creatablelabs/Creatable-D3/README.md

# Creatable-D3
All drawings and sources in Creatable D3
