creatablelabs/Creatable-D3/D3 drawing files/D3 3D modeling/bottom plate assy/bed clip 5 dw 20180131.png

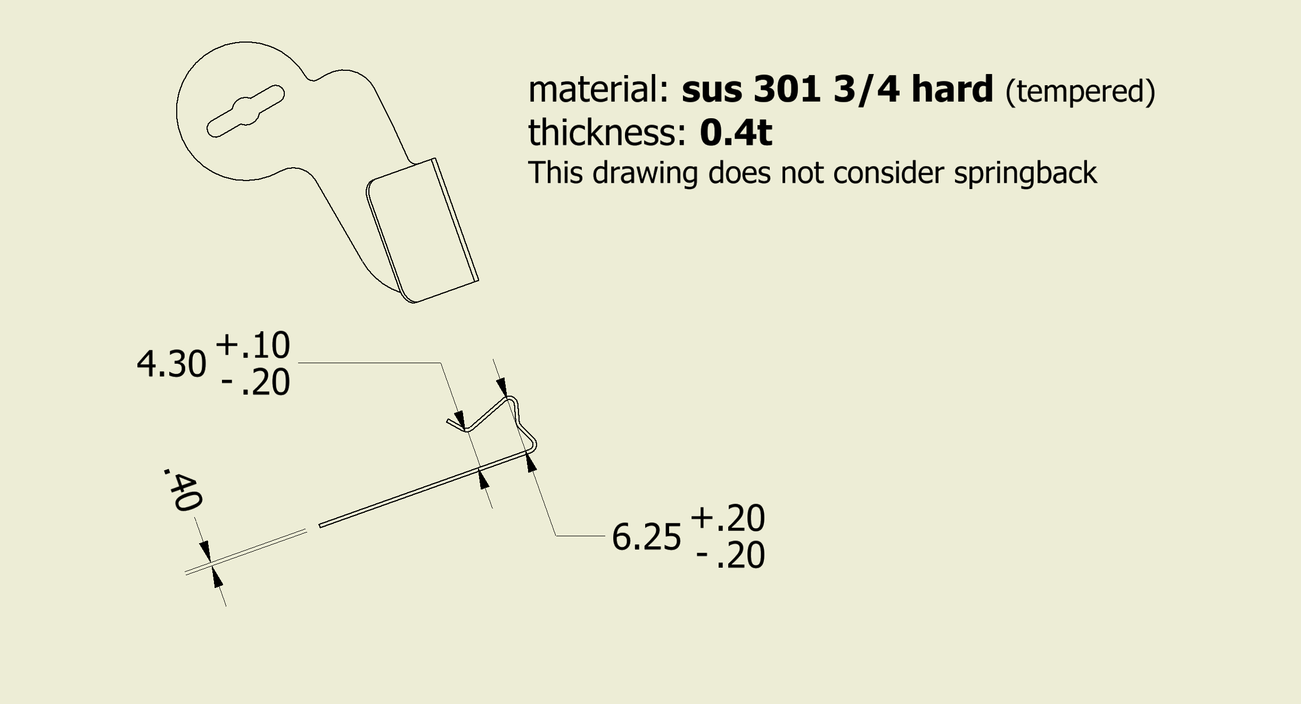
D3 drawing files/D3 3D modeling/bottom plate assy/bed clip 5 dw 20180131.png
