creatablelabs/Creatable-D3/D3 drawing files/D3 3D modeling/oled assy/이게 있어야 에러가 안뜸...png

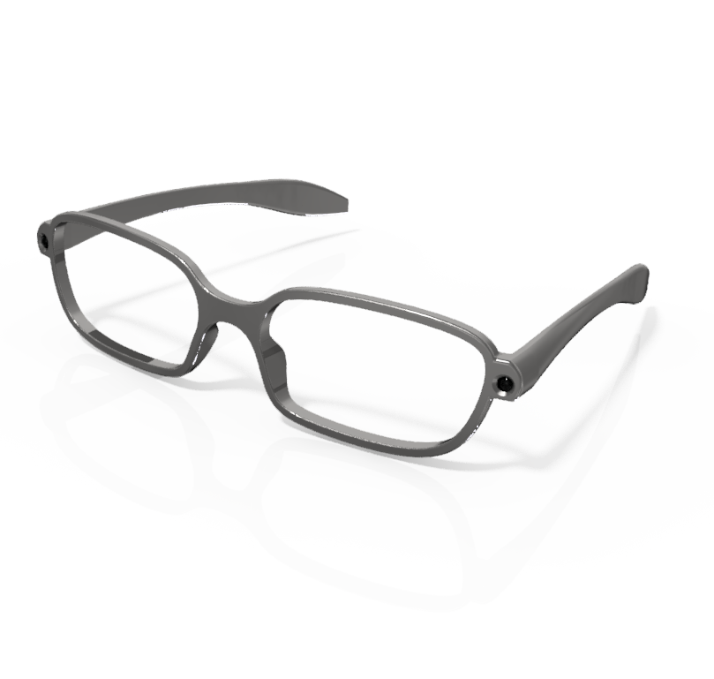
D3 drawing files/D3 3D modeling/oled assy/이게 있어야 에러가 안뜸...png
