creatablelabs/Creatable-D3/D3 drawing files/D3 3D modeling/bottom cover assy/clamp_fixer.stp

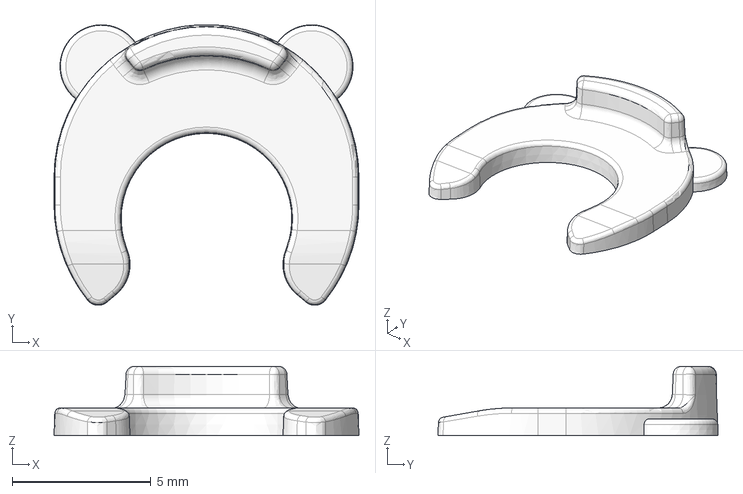
[picture p3: CAD file, 2023-02-28]
D3 drawing files/D3 3D modeling/bottom cover assy/clamp_fixer.stp
11.0 x 10.1 x 2.50 mm
