creatablelabs/Creatable-D3/D3 drawing files/D3 3D modeling/bottom plate assy/leveling_wheel.stp

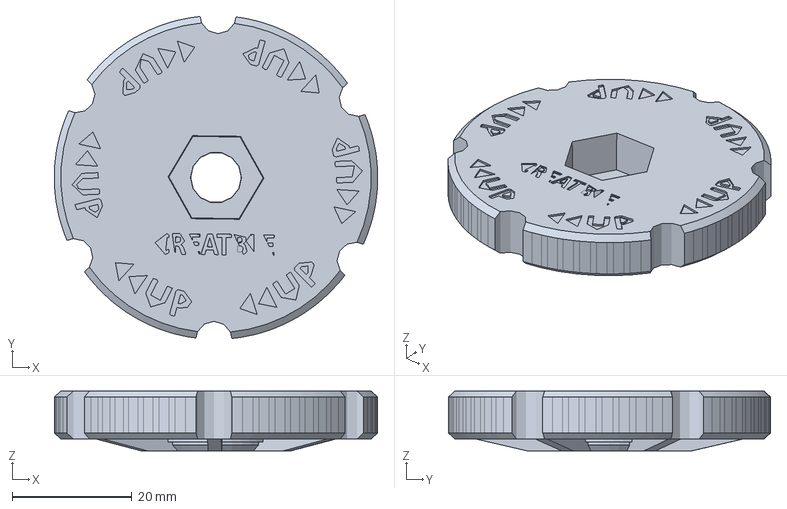
[picture p4: CAD file, 2023-02-28]
D3 drawing files/D3 3D modeling/bottom plate assy/leveling_wheel.stp
54.0 x 53.7 x 10.0 mm
