creatablelabs/Creatable-D3/D3 drawing files/D3 3D modeling/head assy/head_cover.stp

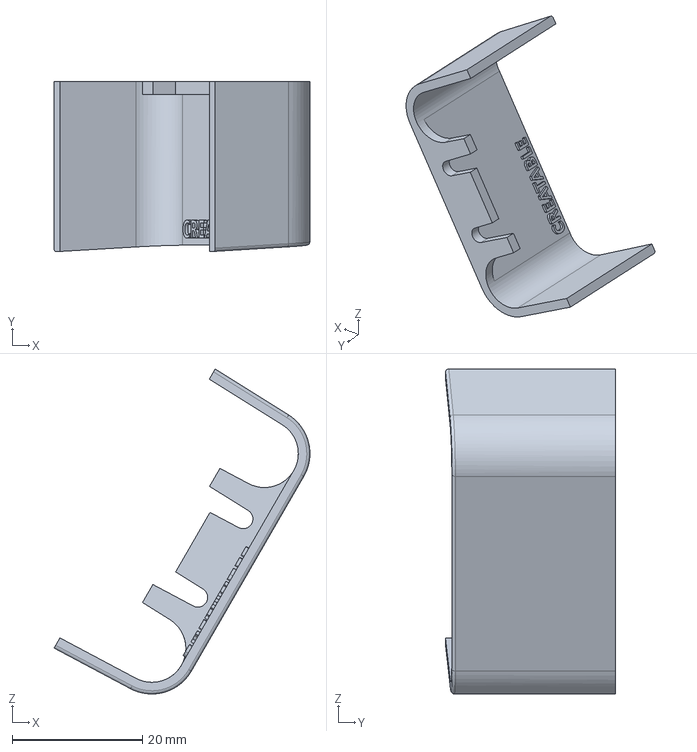
[picture p5: CAD file, 2023-02-28]
D3 drawing files/D3 3D modeling/head assy/head_cover.stp
39.2 x 26.0 x 49.8 mm
