creatablelabs/Creatable-D3/D3 drawing files/D3 3D modeling/head_cable_holder.stp

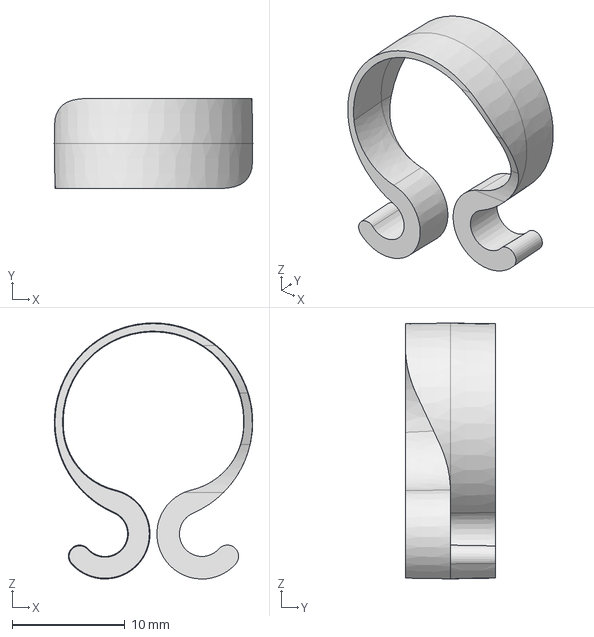
[picture p6: CAD file, 2023-02-28]
D3 drawing files/D3 3D modeling/head_cable_holder.stp
17.6 x 8.00 x 22.7 mm
