creatablelabs/Creatable-D3/D3 drawing files/D3 3D modeling/oled assy/053-Vol_Knob-0417.stp

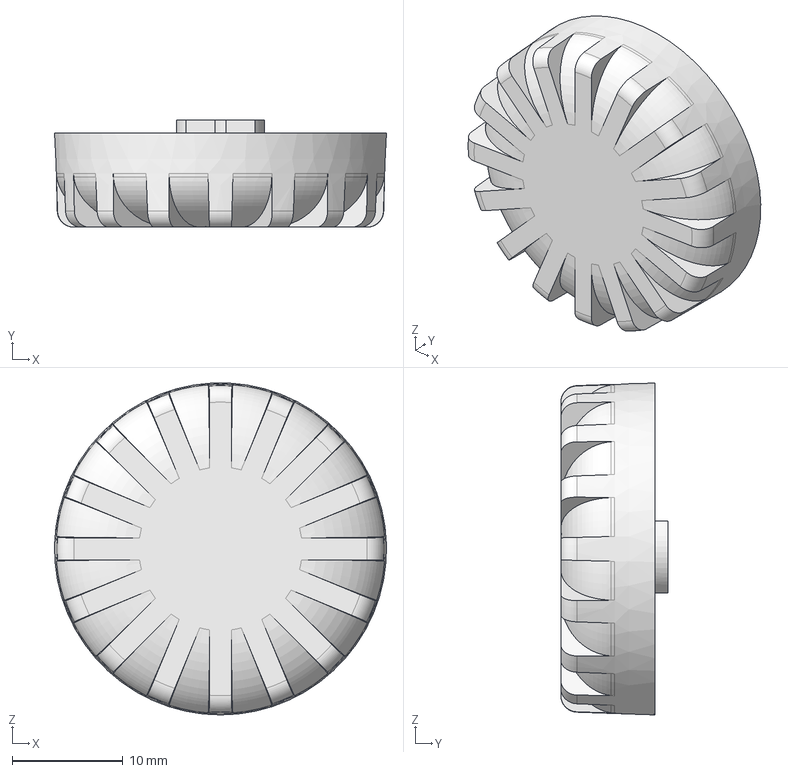
[picture p7: CAD file, 2023-02-28]
D3 drawing files/D3 3D modeling/oled assy/053-Vol_Knob-0417.stp
30.0 x 9.70 x 30.0 mm
