creatablelabs/Creatable-D3/D3 drawing files/D3 3D modeling/top plate assy/top_plate.stp

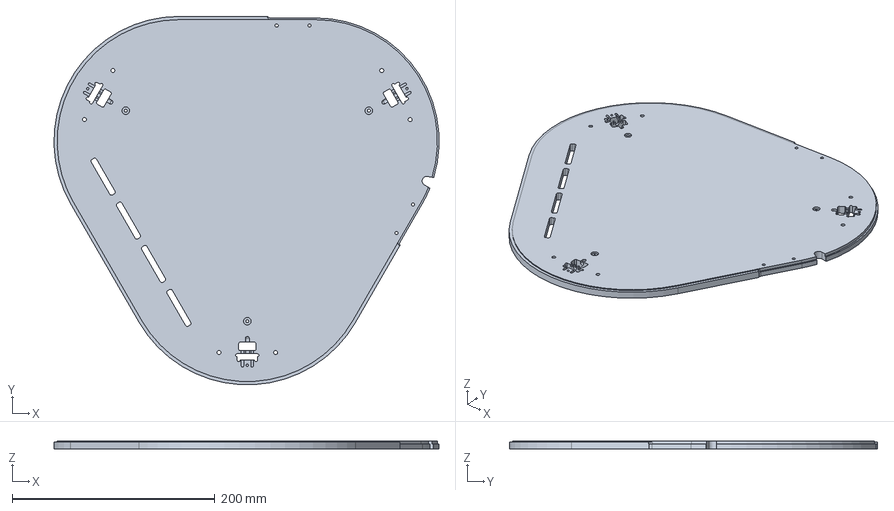
[picture p8: CAD file, 2023-02-28]
D3 drawing files/D3 3D modeling/top plate assy/top_plate.stp
380.1 x 363.5 x 8.00 mm
