creatablelabs/Creatable-D3/D3 drawing files/D3 DWG drawing/사출물/bed clip 5 20180131(new).stp

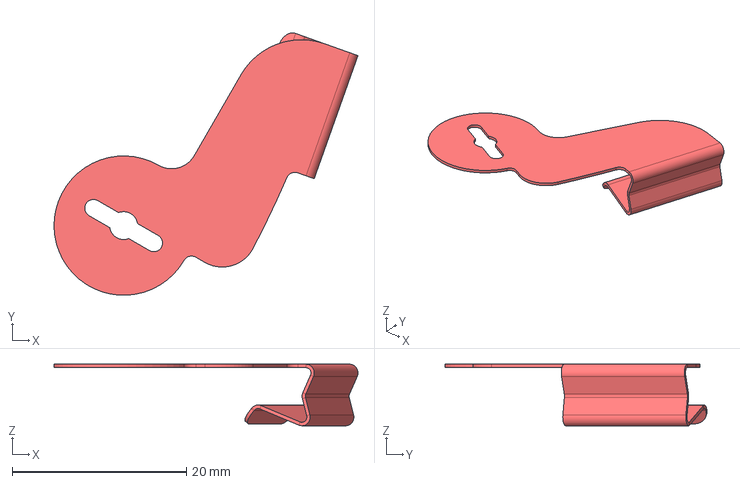
[picture p9: CAD file, 2023-02-28]
D3 drawing files/D3 DWG drawing/사출물/bed clip 5 20180131(new).stp
34.9 x 30.1 x 7.07 mm
