creatablelabs/Creatable-D3/D3 drawing files/D3 3D modeling/bottom cover assy/feeder_ver2.stp

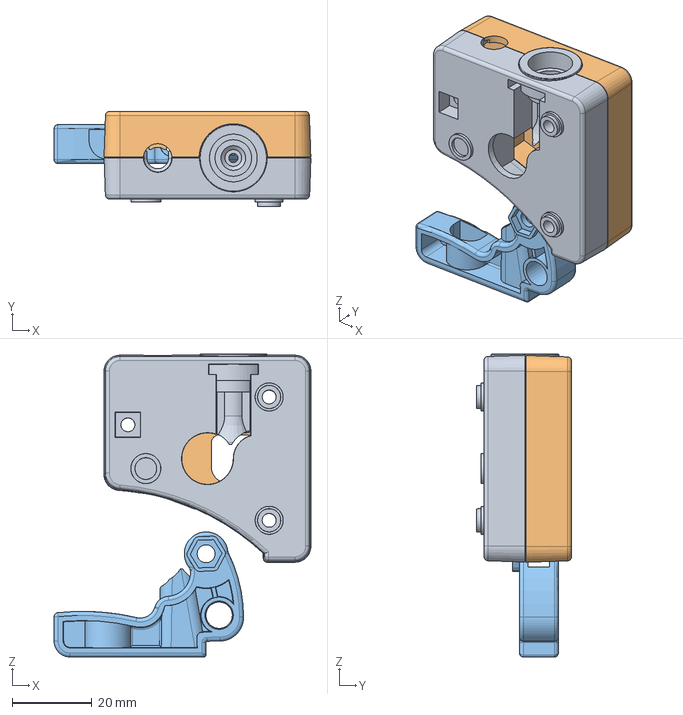
[picture p10: CAD file, 2023-02-28]
D3 drawing files/D3 3D modeling/bottom cover assy/feeder_ver2.stp
64.6 x 23.9 x 76.2 mm
