creatablelabs/Creatable-D3/D3 drawing files/D3 3D modeling/top-cover.stp

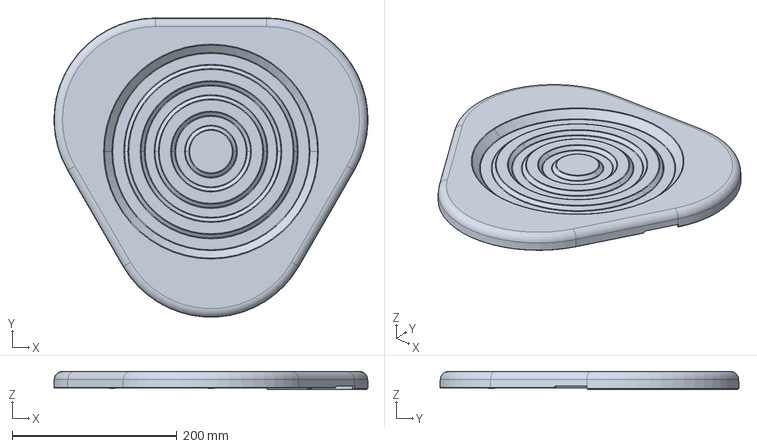
[picture p11: CAD file, 2023-02-28]
D3 drawing files/D3 3D modeling/top-cover.stp
381.7 x 363.5 x 22.0 mm
