creatablelabs/Creatable-D3/D3 drawing files/D3 3D modeling/bottom cover assy/bottom_cover.stp

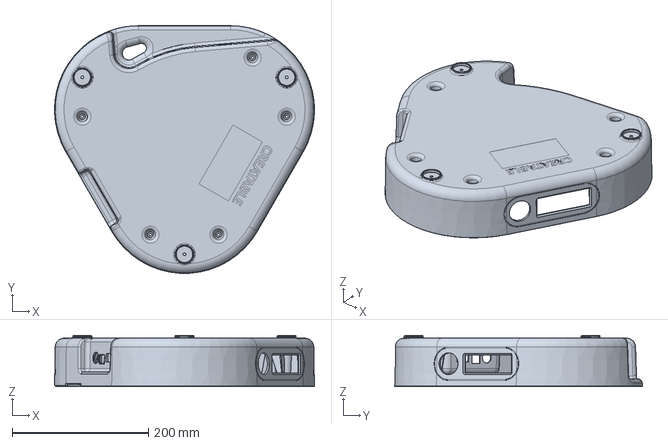
[picture p12: CAD file, 2023-02-28]
D3 drawing files/D3 3D modeling/bottom cover assy/bottom_cover.stp
381.7 x 363.5 x 75.0 mm
