creatablelabs/Creatable-D3/(list of files, cad)

Other CAD files:
D3 drawing files/D3 DWG drawing/밀링/top plate.dwg
D3 drawing files/D3 DWG drawing/선반/rod.dwg
D3 drawing files/D3 DWG drawing/유리업체/glass plate.dwg
D3 drawing files/D3 DWG drawing/판금절곡/filament_hanger.dwg
D3 drawing files/D3 DWG drawing/한국 사급/cleaning_rubber.dwg
D3 drawing files/D3 3D modeling/bottom plate assy/bed clip 5.stp
D3 drawing files/D3 DWG drawing/밀링/head_ass'y rev2.dwg
D3 drawing files/D3 DWG drawing/선반/nozzle cap2.dwg
D3 drawing files/D3 DWG drawing/판금절곡/back cover.dwg
D3 drawing files/D3 DWG drawing/밀링/head_ass'y-topplate rev3.dwg
D3 drawing files/D3 DWG drawing/사출물/feeder_gear.dwg
D3 drawing files/D3 DWG drawing/판금절곡/oled_bracket, motor_fixer, switch_fixer.dwg
D3 drawing files/D3 DWG drawing/밀링/bottom plate.dwg
D3 drawing files/D3 DWG drawing/사출물/head_ass'y rev2.dwg
D3 drawing files/D3 DWG drawing/선반/feeder_spring.dwg
D3 drawing files/D3 DWG drawing/선반/pin.dwg
D3 drawing files/D3 DWG drawing/선반/head_ass'y rev2.dwg
D3 drawing files/D3 DWG drawing/선반/post.dwg
D3 drawing files/D3 DWG drawing/선반/leveling_spring.dwg
D3 drawing files/D3 3D modeling/M3 16 BH_tapping_screw.ipt
D3 drawing files/D3 3D modeling/OldVersions/body assy VER2.0020.iam
D3 drawing files/D3 3D modeling/OldVersions/body assy.0020.iam
D3 drawing files/D3 3D modeling/OldVersions/post.0007.ipt
D3 drawing files/D3 3D modeling/back_cover.ipt
D3 drawing files/D3 3D modeling/body assy.iam
D3 drawing files/D3 3D modeling/bottom cover assy/8025 fan.ipt
D3 drawing files/D3 3D modeling/bottom cover assy/Assembly1.iam
D3 drawing files/D3 3D modeling/bottom cover assy/M5 25 button head.ipt
D3 drawing files/D3 3D modeling/bottom cover assy/M5_square_nut.ipt
D3 drawing files/D3 3D modeling/bottom cover assy/OldVersions/8025 fan.0001.ipt
D3 drawing files/D3 3D modeling/bottom cover assy/OldVersions/Assembly1.0001.iam
D3 drawing files/D3 3D modeling/bottom cover assy/OldVersions/VER.2 LCD.0003.ipt
D3 drawing files/D3 3D modeling/bottom cover assy/OldVersions/bottom cover assy.0007.iam
D3 drawing files/D3 3D modeling/bottom cover assy/OldVersions/bottom_cover VER.2 LCD.0010.ipt
D3 drawing files/D3 3D modeling/bottom cover assy/OldVersions/bottom_cover.0001.ipt
D3 drawing files/D3 3D modeling/bottom cover assy/OldVersions/feeder laver new.0002.ipt
D3 drawing files/D3 3D modeling/bottom cover assy/OldVersions/feeder laver new.0003.ipt
D3 drawing files/D3 3D modeling/bottom cover assy/OldVersions/feeder top new.0006.ipt
D3 drawing files/D3 3D modeling/bottom cover assy/OldVersions/spring.0002.ipt
D3 drawing files/D3 3D modeling/bottom cover assy/bearing.ipt
D3 drawing files/D3 3D modeling/bottom cover assy/bottom cover assy.iam
D3 drawing files/D3 3D modeling/bottom cover assy/bottom_cover.ipt
D3 drawing files/D3 3D modeling/bottom cover assy/clamp_fixer.ipt
D3 drawing files/D3 3D modeling/bottom cover assy/feeder botton new.ipt
D3 drawing files/D3 3D modeling/bottom cover assy/feeder laver new.ipt
D3 drawing files/D3 3D modeling/bottom cover assy/feeder top new.ipt
D3 drawing files/D3 3D modeling/bottom cover assy/filter ver1.ipt
D3 drawing files/D3 3D modeling/bottom cover assy/m3 15 socket_screw.ipt
D3 drawing files/D3 3D modeling/bottom cover assy/m3 25 socket_screw.ipt
D3 drawing files/D3 3D modeling/bottom cover assy/m3 sqaure nut.ipt
D3 drawing files/D3 3D modeling/bottom cover assy/m4 12 Button Head.ipt
D3 drawing files/D3 3D modeling/bottom cover assy/nut_M4.ipt
D3 drawing files/D3 3D modeling/bottom cover assy/pinion_gear.ipt
D3 drawing files/D3 3D modeling/bottom cover assy/rubber_foot.ipt
D3 drawing files/D3 3D modeling/bottom cover assy/spring.ipt
D3 drawing files/D3 3D modeling/bottom cover assy/stepping_motor f.ipt
D3 drawing files/D3 3D modeling/bottom cover assy/tube clamp.ipt
D3 drawing files/D3 3D modeling/bottom cover assy/tubeclamp male.ipt
D3 drawing files/D3 3D modeling/bottom plate assy/OldVersions/bed clip 5.0012.ipt
D3 drawing files/D3 3D modeling/bottom plate assy/OldVersions/bed_clip 3.0001.ipt
D3 drawing files/D3 3D modeling/bottom plate assy/OldVersions/bottom plate assy.0018.iam
D3 drawing files/D3 3D modeling/bottom plate assy/OldVersions/bottom_plate.0036.ipt
D3 drawing files/D3 3D modeling/bottom plate assy/OldVersions/leveling_screw real.0010.ipt
D3 drawing files/D3 3D modeling/bottom plate assy/OldVersions/leveling_screw.0011.ipt
D3 drawing files/D3 3D modeling/bottom plate assy/OldVersions/leveling_spring.0004.ipt
D3 drawing files/D3 3D modeling/bottom plate assy/OldVersions/leveling_wheel.0003.ipt
D3 drawing files/D3 3D modeling/bottom plate assy/OldVersions/new clip.0001.ipt
D3 drawing files/D3 3D modeling/bottom plate assy/bed clip 5.ipt
D3 drawing files/D3 3D modeling/bottom plate assy/bed.ipt
D3 drawing files/D3 3D modeling/bottom plate assy/bottom plate assy.iam
D3 drawing files/D3 3D modeling/bottom plate assy/bottom_plate.ipt
D3 drawing files/D3 3D modeling/bottom plate assy/glass_plate.ipt
D3 drawing files/D3 3D modeling/bottom plate assy/leveling_screw real.ipt
D3 drawing files/D3 3D modeling/bottom plate assy/leveling_screw.ipt
D3 drawing files/D3 3D modeling/bottom plate assy/leveling_spring.ipt
D3 drawing files/D3 3D modeling/bottom plate assy/leveling_wheel.ipt
D3 drawing files/D3 3D modeling/bottom plate assy/m3 5 Socket_Head.ipt
D3 drawing files/D3 3D modeling/bottom plate assy/m8 hex_nut.ipt
D3 drawing files/D3 3D modeling/head assy/HEAD_cover.ipt
D3 drawing files/D3 3D modeling/head assy/OldVersions/fan cover.0002.ipt
D3 drawing files/D3 3D modeling/head assy/OldVersions/fan cover.0005.ipt
D3 drawing files/D3 3D modeling/head assy/OldVersions/fan.0004.ipt
D3 drawing files/D3 3D modeling/head assy/OldVersions/head assy.0025.iam
D3 drawing files/D3 3D modeling/head assy/OldVersions/head_top_plate.0039.ipt
D3 drawing files/D3 3D modeling/head assy/OldVersions/heat_block.0008.ipt
D3 drawing files/D3 3D modeling/head assy/OldVersions/heat_sink.0011.ipt
D3 drawing files/D3 3D modeling/head assy/OldVersions/nozzle 0.4.0014.ipt
D3 drawing files/D3 3D modeling/head assy/OldVersions/nozzle0.25.0002.ipt
D3 drawing files/D3 3D modeling/head assy/OldVersions/nozzle0.6.0002.ipt
D3 drawing files/D3 3D modeling/head assy/OldVersions/nozzle0.8.0002.ipt
D3 drawing files/D3 3D modeling/head assy/OldVersions/nozzle_cap.0012.ipt
D3 drawing files/D3 3D modeling/head assy/OldVersions/nozzle_cover.0006.ipt
D3 drawing files/D3 3D modeling/head assy/OldVersions/teflon_guide.0014.ipt
D3 drawing files/D3 3D modeling/head assy/disc_spring.ipt
D3 drawing files/D3 3D modeling/head assy/fan cover.ipt
D3 drawing files/D3 3D modeling/head assy/fan.ipt
D3 drawing files/D3 3D modeling/head assy/head assy.iam
D3 drawing files/D3 3D modeling/head assy/head_top_plate.ipt
D3 drawing files/D3 3D modeling/head assy/heat cut flim.ipt
D3 drawing files/D3 3D modeling/head assy/heat_block.ipt
D3 drawing files/D3 3D modeling/head assy/heat_cartridge.ipt
D3 drawing files/D3 3D modeling/head assy/heat_sink.ipt
D3 drawing files/D3 3D modeling/head assy/m3 10 socket_screw.ipt
D3 drawing files/D3 3D modeling/head assy/nozzle 0.4.ipt
D3 drawing files/D3 3D modeling/head assy/nozzle0.25.ipt
D3 drawing files/D3 3D modeling/head assy/nozzle0.6.ipt
D3 drawing files/D3 3D modeling/head assy/nozzle0.8.ipt
D3 drawing files/D3 3D modeling/head assy/nozzle_cap.ipt
D3 drawing files/D3 3D modeling/head assy/nozzle_cover.ipt
D3 drawing files/D3 3D modeling/head assy/nozzle_plug.ipt
D3 drawing files/D3 3D modeling/head assy/teflon_guide.ipt
D3 drawing files/D3 3D modeling/head assy/thermistor_ass'y.ipt
D3 drawing files/D3 3D modeling/head assy/tube guide bushing.ipt
D3 drawing files/D3 3D modeling/head_cable_holder.ipt
D3 drawing files/D3 3D modeling/lift block assy/Ms3 8 BH_tapping_screw.ipt
D3 drawing files/D3 3D modeling/lift block assy/OldVersions/belt_fixer.0001.ipt
D3 drawing files/D3 3D modeling/lift block assy/OldVersions/belt_fixer.0001_1.ipt
D3 drawing files/D3 3D modeling/lift block assy/OldVersions/lift block assy.0003.iam
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
