creatablelabs/Creatable-D3/(list of files, drawings)

Other design files:
D3 PCB/Hardware/MainBoard/Mainboard.DSN
