creatablelabs/Creatable-D3/D3 PCB/Hardware/OLED Board/OLED_Board.brd

## EAGLE design D3 PCB/Hardware/OLED Board/OLED_Board.brd (2023-02-28)

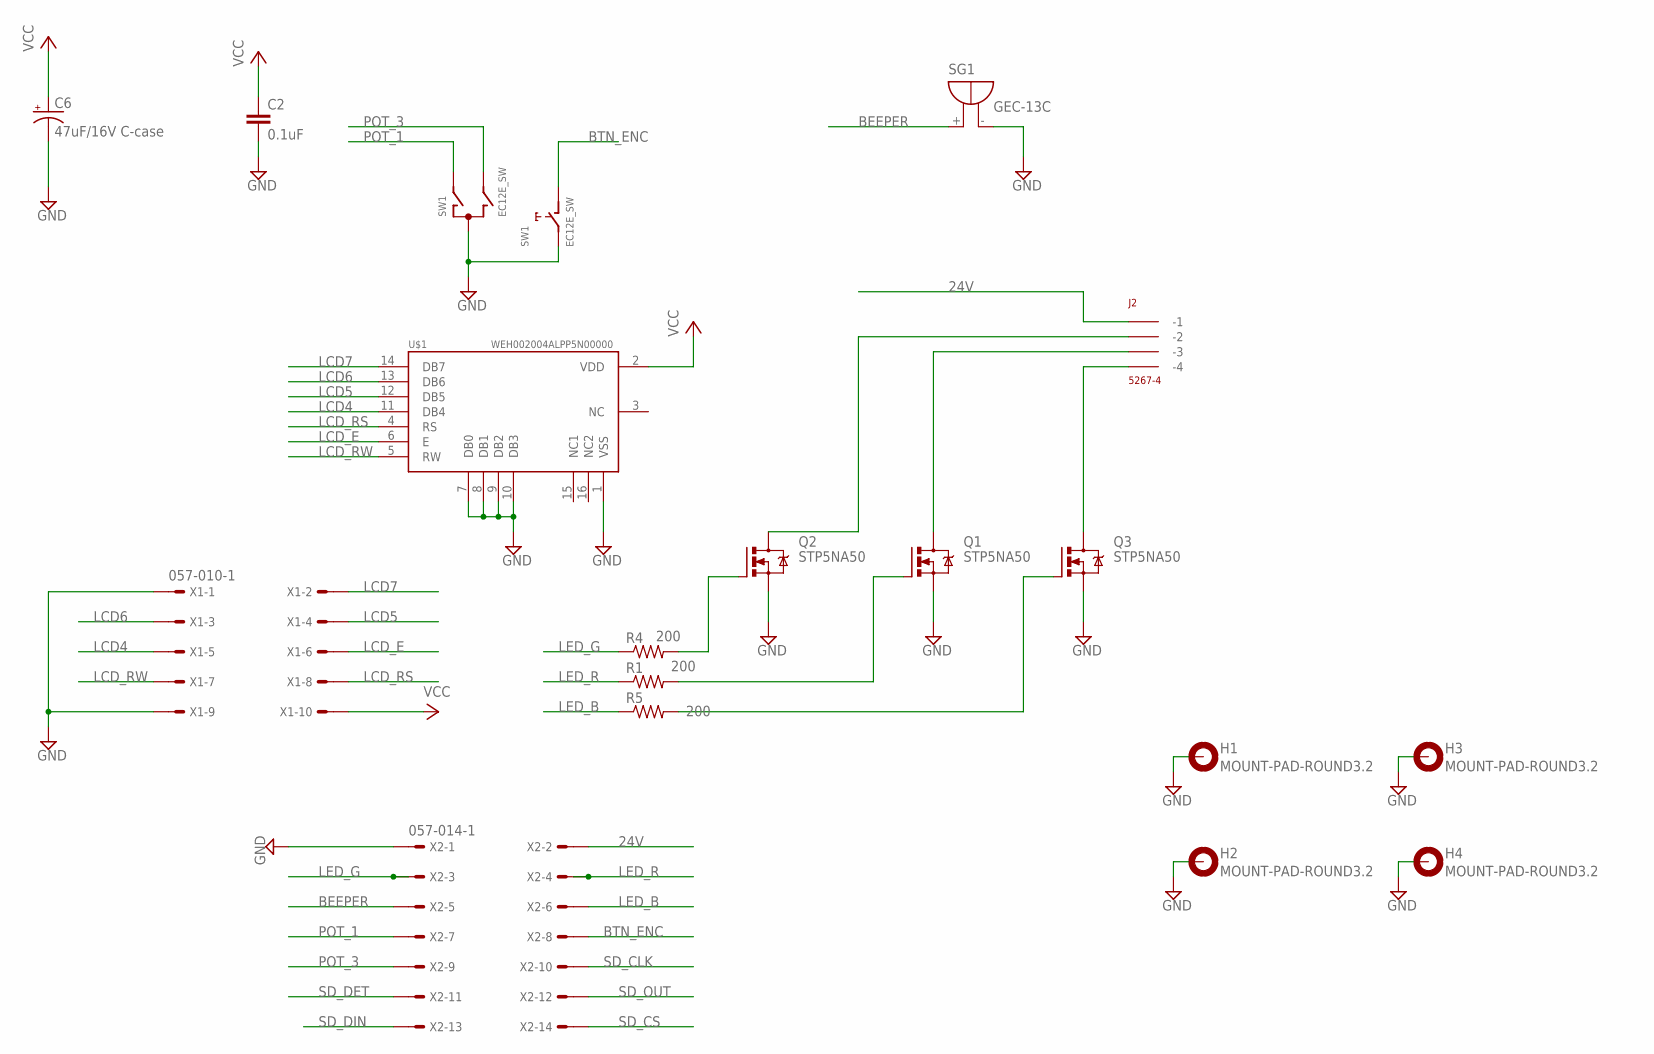
[picture p13: schematic OLED_Board.sch, sheet 1]

Parts:
C2: 0.1uF; C0805
C6: 47uF/16V C-case; EIA6032
H1, H2, H3, H4: MOUNT-PAD-ROUND3.2; 3,2-PAD
J2: 5267-4
Q1, Q2, Q3: STP5NA50; TO220BV
R1, R4, R5: 200; R2012
SG1: GEC-13C; F/TMB
SW1: EC12E_SW; ALPS_EC12E_SW
U$1: OLED; WEH002004ALPP5N00000
X1: 057-010-1
X2: 057-014-1

Connections:
24V: J2.P$1 (-1), X2.2
BEEPER: SG1.+, X2.5
BTN_ENC: SW1.D (1), X2.8
GND: C2.2, C6.P$2 (-), H1.B3,2, H2.B3,2, H3.B3,2, H4.B3,2, Q1.S, Q2.S, Q3.S, SG1.-, SW1.C, SW1.E (2), U$1.1 (VSS), U$1.7 (DB0), U$1.8 (DB1), U$1.9 (DB2), U$1.10 (DB3), X1.1, X1.9, X2.1; also elsewhere on the board
LCD4: U$1.11 (DB4), X1.5
LCD5: U$1.12 (DB5), X1.4
LCD6: U$1.13 (DB6), X1.3
LCD7: U$1.14 (DB7), X1.2
LCD_E: U$1.6 (E), X1.6
LCD_RS: U$1.4 (RS), X1.8
LCD_RW: U$1.5 (RW), X1.7
LED_B: R5.1, X2.6
LED_G: R4.1, X2.3
LED_R: R1.1, X2.4
unnamed: Q2.G, R4.2
unnamed: Q1.G, R1.2
unnamed: Q3.G, R5.2
unnamed: J2.P$2 (-2), Q2.D
unnamed: J2.P$3 (-3), Q1.D
unnamed: J2.P$4 (-4), Q3.D
POT_1: SW1.A, X2.7
POT_3: SW1.B, X2.9
SD_CLK: X2.10; also elsewhere on the board
SD_CS: X2.14; also elsewhere on the board
SD_DET: X2.11; also elsewhere on the board
SD_DIN: X2.13; also elsewhere on the board
SD_OUT: X2.12; also elsewhere on the board
VCC: C2.1, C6.P$1 (+), U$1.2 (VDD), X1.10; also elsewhere on the board

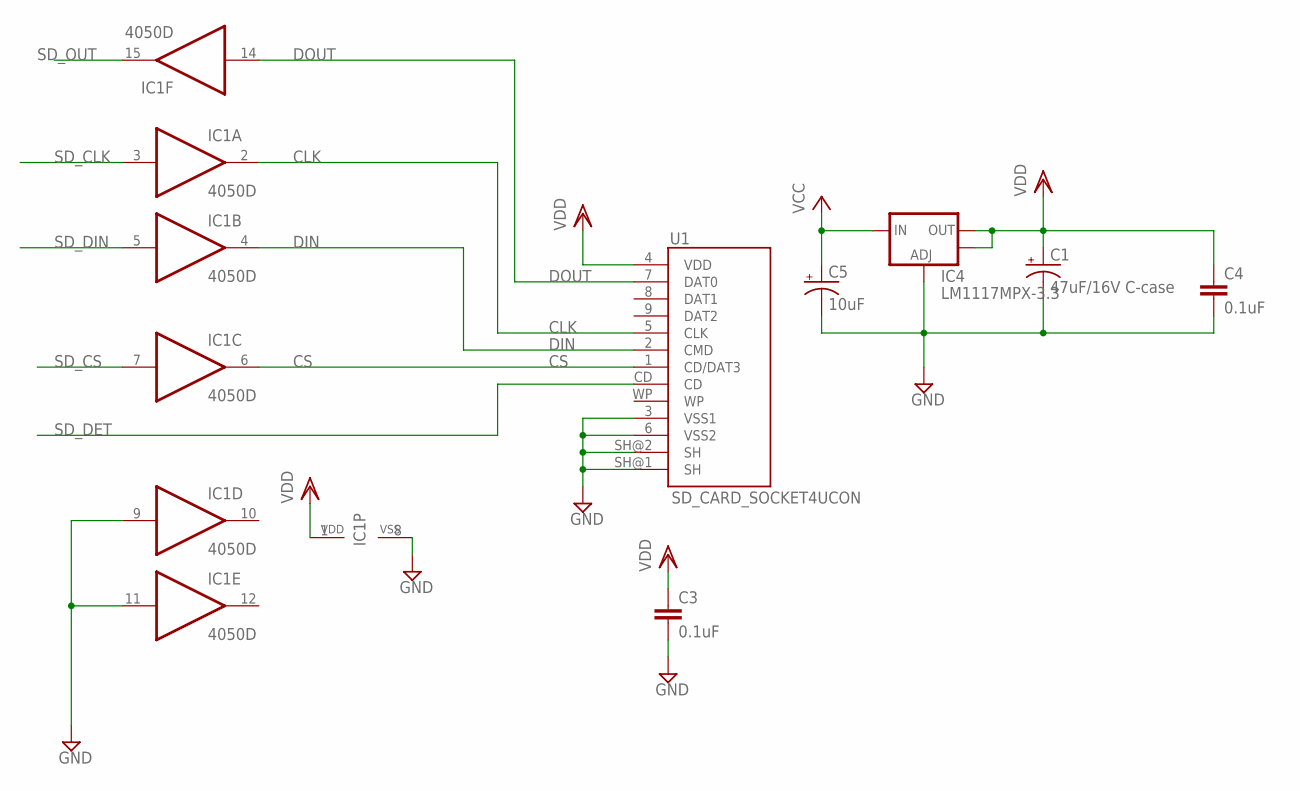
[picture p14: schematic OLED_Board.sch, sheet 2]

Parts:
C1: 47uF/16V C-case; EIA6032
C3, C4: 0.1uF; C0805
C5: 10uF; CT3216
IC1: 4050D; SO16
IC4: LM1117MPX-3.3; SOT223
U1: SD_CARD_SOCKET4UCON; SDCARD_4UCONN

Connections:
CLK: IC1.2 (O), U1.5 (CLK)
CS: IC1.6 (O), U1.1 (CD/DAT3)
DIN: IC1.4 (O), U1.2 (CMD)
DOUT: IC1.14 (I), U1.7 (DAT0)
GND: C1.P$2 (-), C3.2, C4.2, C5.-, IC1.8 (VSS), IC1.9 (I), IC1.11 (I), IC4.1 (ADJ), U1.3 (VSS1), U1.6 (VSS2), U1.SH@1 (SH), U1.SH@2 (SH); also elsewhere on the board
SD_CLK: IC1.3 (I); also elsewhere on the board
SD_CS: IC1.7 (I); also elsewhere on the board
SD_DET: U1.CD; also elsewhere on the board
SD_DIN: IC1.5 (I); also elsewhere on the board
SD_OUT: IC1.15 (O); also elsewhere on the board
VCC: C5.+, IC4.3 (IN); also elsewhere on the board
VDD: C1.P$1 (+), C3.1, C4.1, IC1.1 (VDD), IC4.2 (OUT), IC4.4 (OUT), U1.4 (VDD)

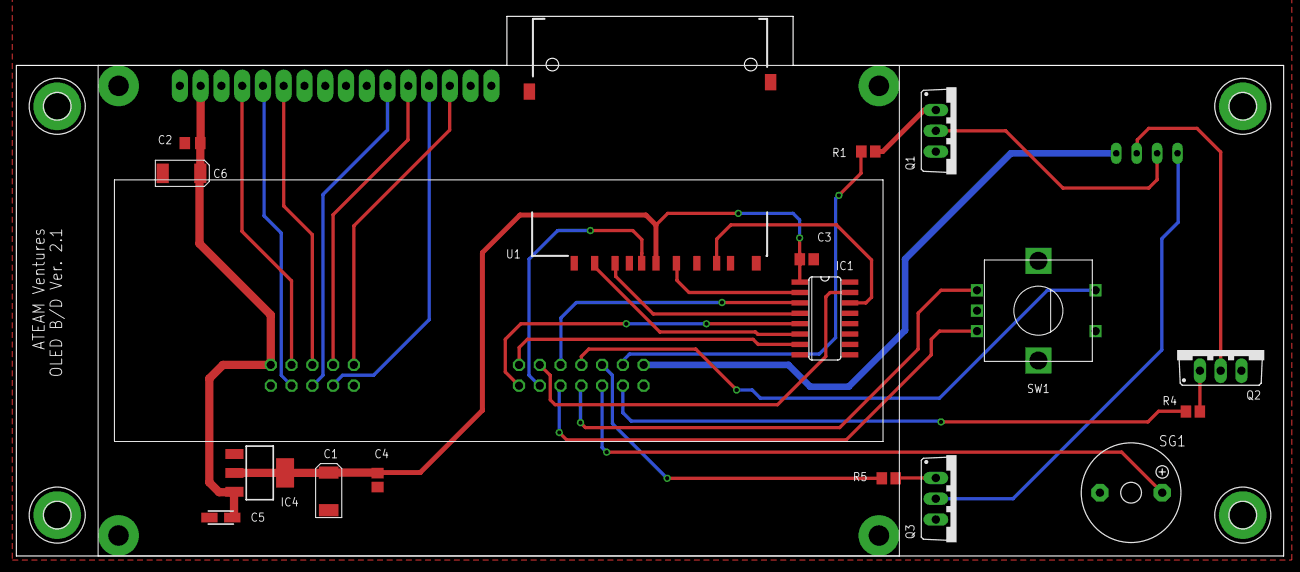
[picture p15: board OLED_Board.brd from above]

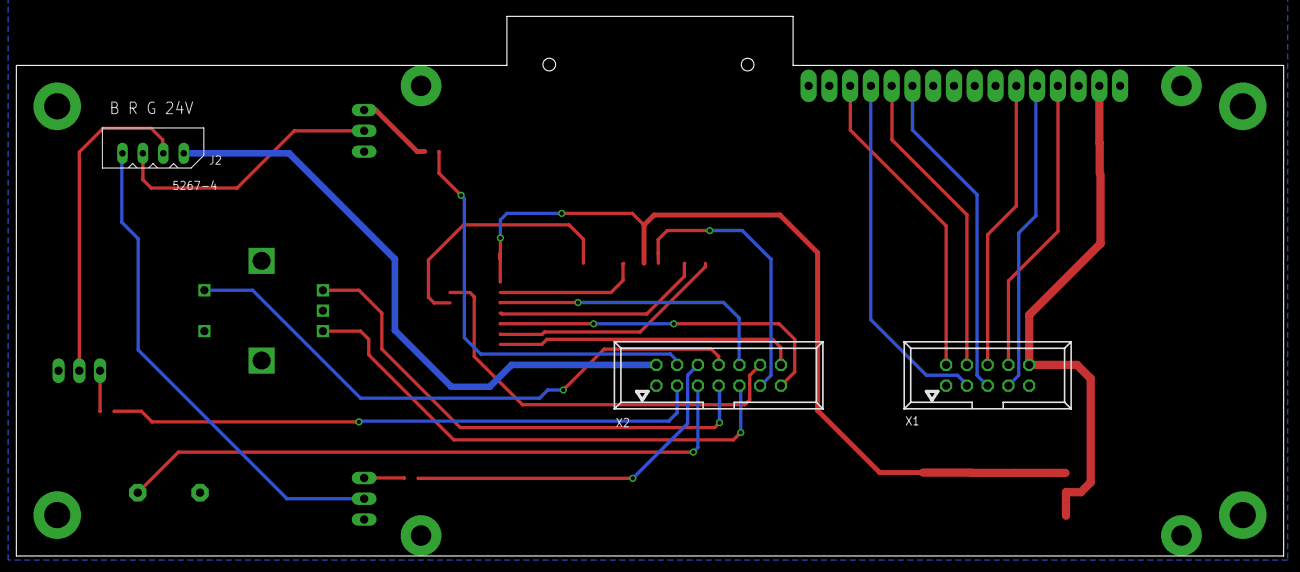
[picture p16: board OLED_Board.brd from below]

Board: 2 copper layers, 155.0 x 66.0 mm, 25 parts (3 on the bottom side), 33 nets.
