creatablelabs/Creatable-D3/D3 PCB/Hardware/HeatBed/HeatBed.brd

## EAGLE design D3 PCB/Hardware/HeatBed/HeatBed.brd (2023-02-28)

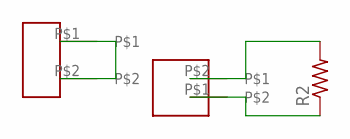
[picture p17: schematic HeatBed.sch]

Parts:
R2: R-US_R0402; R0402
U$2: SMD_WAFER_2; SMD_WAFER_02
U$3: SMD_TERMINAL_2; SMD_5MM_2

Connections:
unnamed: R2.2, U$2.P$2
unnamed: R2.1, U$2.P$1
unnamed: U$3.P$1, U$3.P$2

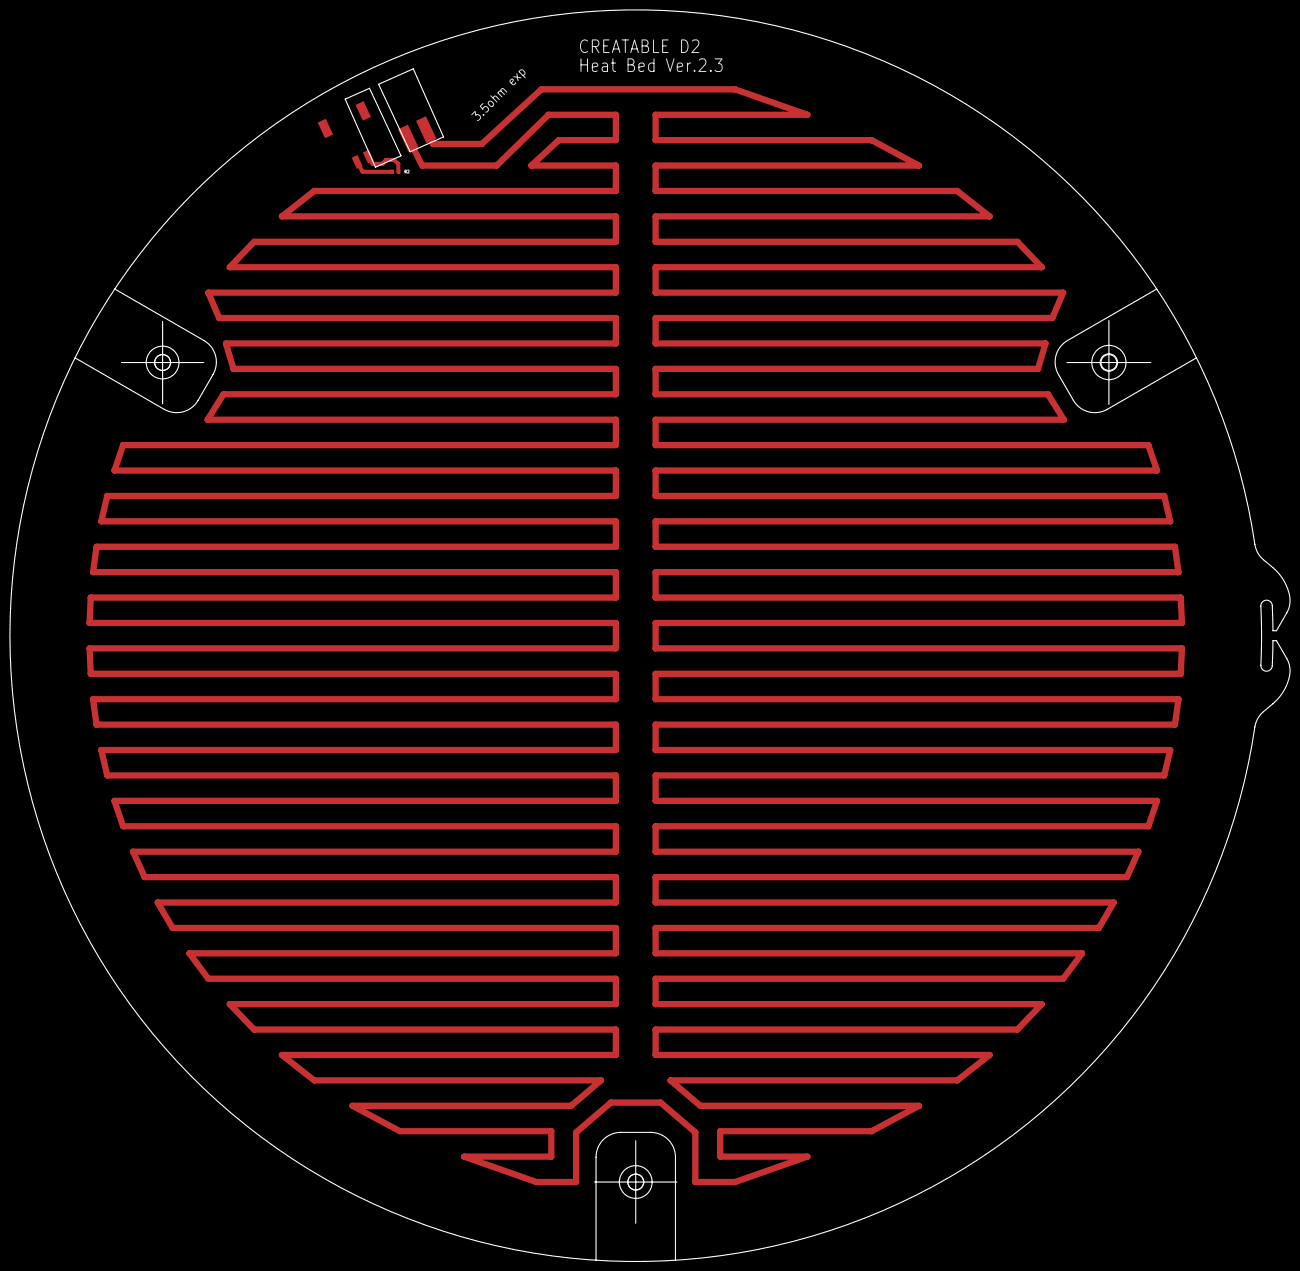
[picture p18: board HeatBed.brd from above]

Board: 2 copper layers, 257.7 x 252.0 mm, 4 parts (1 on the bottom side), 3 nets.

Other parts of the board:
U$1: HEAT_BED2.3(R126_T2.3)
